JeielArguello/STM32-RTOS-Servo-Control/(commit log)

2026-05-12 Commit inicial
    [Bluepill_F103 Debug.cfg]
2026-05-15 Feat: Board_config general, InputHID implementada
2026-05-17 Feat: App de consola, f411 configuracion de pines
    [Bluepill_F103 Debug (1).cfg]
2026-05-18 Feat: Conexion USB HID Funcionando. Fix: QueuePeek con prioridades
    [Bluepill_F103.ioc, main.c]
2026-05-19 Fix: Descriptor de reporte correcto, tim4 funcionando
    [main.c, main.h]
2026-05-21 Fix: Aumento de heap. Feat: Software Timer, Verificacion de errores
    [Bluepill_F103.ioc, main.c]
2026-05-21 Feat: Agregando Doxyfile, mas verificacion de errores, Fix: Aumento de stack
    [Bluepill_F103.ioc, main.c]
2026-05-23 Feat: Algoritmo PID implementado, App recibe grados, Flash en 128KB. Fix: renombre de atributos, cambios stepper lib
    [main.c]
2026-05-24 Fix: aumento prioridad Timer, includes, reemplazo Queue por Semp contador, uso de punto fijo
    [main.h]
2026-05-29 Fix: Errores de signos y uint, limpiando codigo. Feat: Cambio de step por speed, reduciendo complejidad
    [main.c]
2026-05-30 Feat: App refactorizada. Fix: PID, seteo de speed
    [main.c]
2026-06-07 Feat: Notificaciones. Fix: Derivativo, struct debug, Q16, limpieza USBHID
    [main.c]
2026-06-08 Fix: Mejorando precision, rotacion, PID
2026-06-11 Feat: Agregando rotation, Cambio de semaforo a Queue.
2026-06-12 Feat: Libreria encoder, chequeo de errores, filtros en sensor. Fix: eliminamos promedio de sensor, mayo fps en App, cambio semaphore por Queue
    [main.c]
2026-06-17 Feat: Modularizacion de PID portable, Redondeo, Filtro Derivada, Timer en PWM. Fix: Calculo de ARR, Prioridades
2026-07-03 Feat: Agregando avance e informe final. Fix: limpiando comentarios
    [main.c]
2026-07-03 Feat: Agregando imagenes de diagramas a el informe
2026-07-03 Fix: Cambiando el diagrama de tareas de png a pdf
