JeielArguello/STM32-RTOS-Servo-Control/(notices)

Notices in the files:
Boards/Discovery_F411/Core/Inc/main.h:
Copyright (c) 2026 STMicroelectronics.
All rights reserved.
This software is licensed under terms that can be found in the LICENSE file
